DevanMetz/reflector-lantern/stl/reflector.stl

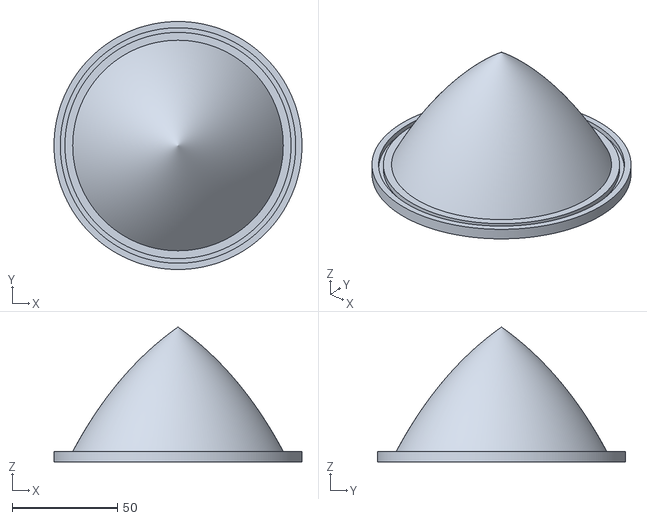
[picture p3: CAD file, 2026-09-29]
stl/reflector.stl
117.8 x 117.8 x 64.1
