DevanMetz/reflector-lantern/stl/tube.stl

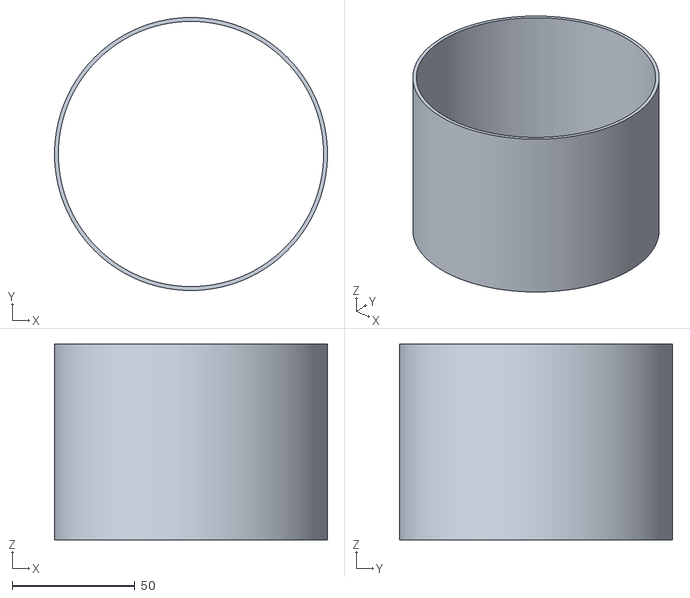
[picture p4: CAD file, 2026-09-29]
stl/tube.stl
111.2 x 111.2 x 79.7
