DevanMetz/reflector-lantern/stl/base.stl

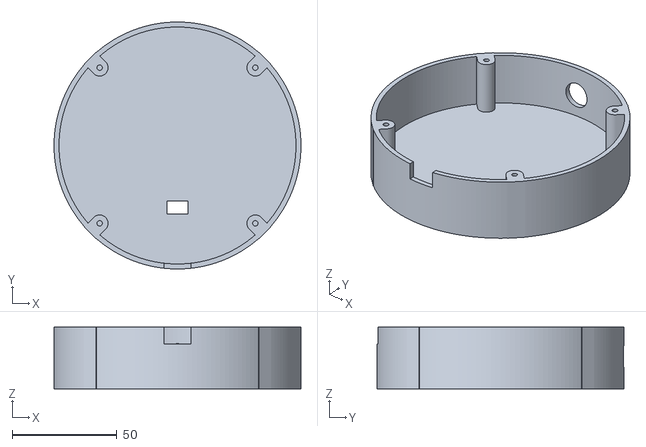
[picture p5: CAD file, 2026-09-29]
stl/base.stl
117.8 x 117.8 x 29.5
