DevanMetz/reflector-lantern/stl/tube_vase.stl

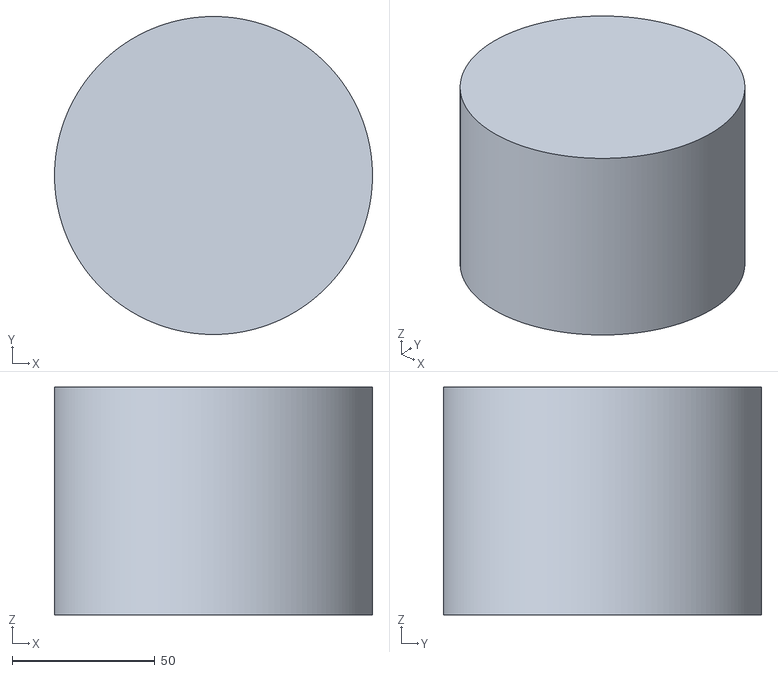
[picture p6: CAD file, 2026-09-29]
stl/tube_vase.stl
111.2 x 111.2 x 79.7
