DevanMetz/reflector-lantern/stl/lid.stl

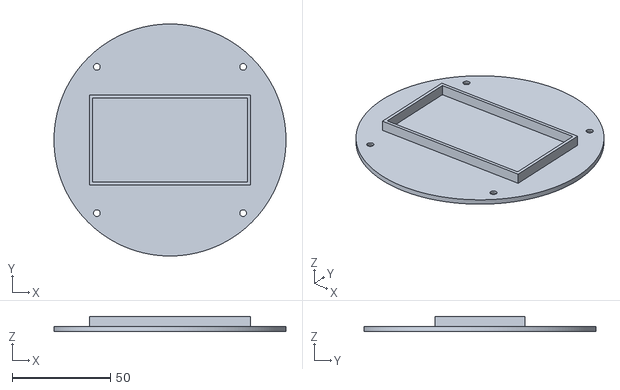
[picture p7: CAD file, 2026-09-29]
stl/lid.stl
117.8 x 117.8 x 7.40
